TranVanVinh74/CAN_RTOS/node1-sensor/app/src/task_can_tx.c

#include "task_can_tx.h"

#include "FreeRTOS.h"
#include "task.h"

#include "app_cfg.h"
#include "app_ipc.h"
#include "can_protocol.h"
#include "hal_can.h"

volatile uint32_t g_canTxQueueTimeoutCount = 0;

static TaskHandle_t xCanTxTaskHandle = NULL;

static void prvCanTxTask(void *pvParameters) {
    (void)pvParameters;

    for (;;) {
        SensorData_t data;
        uint8_t payload[CAN_DLC_SENSOR];

        if (xQueueReceive(xSensorQueue, &data, pdMS_TO_TICKS(TASK_CAN_TX_QUEUE_WAIT_MS)) !=
            pdPASS) {
            g_canTxQueueTimeoutCount++;
            continue;
        }

        can_pack_sensor(data.temperature, data.humidity, data.gas_raw, data.sensor_faults, payload);
        hal_can_send(CAN_ID_SENSOR, payload, CAN_DLC_SENSOR);
    }
}

BaseType_t task_can_tx_create(void) {
    return xTaskCreate(prvCanTxTask, "CAN_TX", TASK_CAN_TX_STACK_WORDS, NULL, TASK_CAN_TX_PRIO,
                       &xCanTxTaskHandle);
}
