TranVanVinh74/CAN_RTOS/node3-gateway/app/inc/app_cfg.h

#ifndef APP_CFG_H
#define APP_CFG_H

#include "FreeRTOS.h"

#define TASK_COMM_PRIO (tskIDLE_PRIORITY + 2)
#define TASK_COMM_STACK_WORDS 512U
#define TASK_COMM_IDLE_DELAY_MS 1U
#define TASK_COMM_WAIT_DELAY_MS 10U

#define SENSOR_QUEUE_LENGTH 1U
#define THRESHOLD_QUEUE_LENGTH 1U
#define SENSOR_FRESH_TIMEOUT_MS 3000U

#define MODEM_BOOT_WAIT_MS 3000U
#define MODEM_AT_RETRY_MS 2000U
#define MODEM_IDLE_CHECK_MS 30000U

#define CALL_DURATION_MS 30000U
#define CALL_INTERVAL_MS 60000U

#endif
