TranVanVinh74/CAN_RTOS/node1-sensor/app/inc/app_cfg.h

#ifndef APP_CFG_H
#define APP_CFG_H

#include "FreeRTOS.h"

#define TASK_SENSOR_PRIO (tskIDLE_PRIORITY + 2)
#define TASK_SENSOR_STACK_WORDS 256U
#define TASK_SENSOR_PERIOD_MS 500U
#define TASK_SENSOR_MQ5_SAMPLES 8U
#define TASK_SENSOR_QUEUE_SEND_TIMEOUT_MS 10U

#define TASK_CAN_TX_PRIO (tskIDLE_PRIORITY + 3)
#define TASK_CAN_TX_STACK_WORDS 256U
#define TASK_CAN_TX_QUEUE_WAIT_MS 1000U

#define SENSOR_QUEUE_LENGTH 5U

#endif
