TranVanVinh74/CAN_RTOS/(commit log)

2026-10-31 chore(setup): add three-node STM32 FreeRTOS project skeleton
2026-10-31 feat(sensor): add DHT11 and MQ5 drivers for Node1
2026-11-02 feat(sensor): restore validated Node1 runtime from supplied project
2026-11-04 Verify Node2 TFT display with CAN sensor data
2026-11-04 Verify three-node CAN system with relay and call alerts at ADC 2000
2026-11-10 build: make keil projects regenerable and ignore build output
    - *.uvoptx was ignored, so a clean clone had no Node*.uvoptx; CubeMX
    6.14.1 then fails while updating the MDK-ARM project and leaves
    Node*.uvprojx with 7 of its 37 source files
    - track the default Node*.uvoptx generated by CubeMX (ST-Link selected);
    with it, regenerating keeps all files and the user-added Lib group
    - stop tracking .lnp, .sct and ExtDll.iex: Keil rewrites them on every
    build (memory layout comes from the target dialog)
    - ignore Keil and GCC build output, Python caches, editor and OS files,
    local secrets and local-only folders
2026-11-10 build: rename node projects by role
    - Node1/Node2/Node3 said nothing about what each board does, and the
    gateway project sat in a nested Node3/Node3 folder
    - rename the folders to node1-sensor, node2-actuator and node3-gateway
    and flatten the gateway folder
    - rename the .ioc, .uvprojx and .uvoptx files, the Keil target and
    output name, RTE/_<target> and the DebugConfig file to match, so
    CubeMX keeps updating the existing Keil project instead of creating a
    new one without the user-added Lib group and include path
    - update paths in the README and the build output pattern in .gitignore
    - checked: arm-none-eabi-gcc syntax check of every source listed in the
    three projects passes; Cub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
2026-11-10 build: move the three nodes from Keil MDK to STM32CubeIDE
    - the projects only built with Keil MDK and ARM Compiler 5, which run
    on Windows; development now happens on Ubuntu
    - replace MDK-ARM/ with STM32CubeIDE project files (.project, .cproject),
    the GCC startup file, the linker script and syscalls.c/sysmem.c, all
    generated by CubeMX 6.14.1 from STM32Cube FW_F1 V1.8.7
    - replace the FreeRTOS RVDS port with the GCC port of the same release
    - add Lib/ to the source folders and include paths of node1 and node2
    - Core/ is copied unchanged: main.c was edited outside the USER CODE
    blocks, so regenerating it from the .ioc would drop tested code
    (startup order, error codes, ADC sample time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
2026-11-10 build: keep .cproject in the format STM32CubeIDE writes
    - opening the projects in STM32CubeIDE 1.18.1 rewrote the three
    .cproject files: one include path and one source entry per line, and
    an empty build targets module in node3
    - commit the rewritten files so the IDE does not leave a diff behind;
    source folders and include paths are unchanged
2026-11-10 build: ignore STM32CubeIDE debug launch files
    - STM32CubeIDE creates <project>.launch on the first debug session; it
    holds per-machine settings such as the absolute ST-Link log path and
    the probe reset strategy
2026-11-10 docs: add MIT license
    - the repository had no license, so reuse terms were undefined
    - MIT covers the firmware written for this project; STM32 HAL, CMSIS
    and FreeRTOS keep their own licenses in their folders
2026-11-10 docs: rewrite the README as a short project entry point
    - the README had grown to 617 lines with personal notes, repository
    links, an outdated branch list and Keil-specific steps
    - keep the registered project title, the three ECU roles, features,
    repository structure, getting started and current limitations
2026-11-12 refactor(node1): split sensor firmware into bsp, hal and app layers
    main.c held the drivers, both tasks and the CAN framing, and its USER CODE
    markers were broken. Drivers move to hal/ (hal_mq5, hal_dht11, hal_can), pin
    mapping to bsp/, tasks and queue to app/, and the 0x100 frame layout to
    common/can_protocol.h. main.c now only initialises the board, IPC and tasks.
    Checked on the Node1 board: 0 warnings, 500 ms period, payload matches
    g_sensorDebug, CAN ESR shows ACK error with TEC +8 per frame as before.
2026-11-12 fix(node1): stop enabling CAN reception on the sensor node
    Node1 accepted every ID into FIFO0 and enabled the RX pending interrupt,
    but nothing read the FIFO. The first frame from another node kept the
    interrupt firing, starved both tasks and stopped the 0x100 frames.
    Node1 only transmits, so it no longer configures a filter or enables the
    RX interrupt; frames are still acknowledged on the bus.
    Checked on hardware: a 0x7E2 frame sent from Node2 froze the old Node1
    (Node2 stuck at 1003 frames); with this change Node1 keeps sending and
    Node2 keeps receiving 0x100 after the same frame.
2026-11-12 refactor(node2): split actuator firmware into bsp, hal and app layers
    main.c held the TFT and relay logic, the CAN filter and RX callback, and
    most CubeMX markers were gone. TFT, font, relay and CAN move to hal/
    (hal_tft, hal_tft_font, hal_relay, hal_can), pin mapping and error codes to
    bsp/, the task and queue to app/, and frame decoding to
    common/can_protocol.h. The CAN ISR now only reads the FIFO and hands frames
    to the app, and the TFT pins are defined once in main.h.
    Checked on the Node2 board with Node1 on the bus: 0 warnings, frames
    received and decoded to the values Node1 sent, TFT shows the data, the relay
    switches a 5 V fan when PB0 is driven high, with no reset or CAN errors.
2026-11-12 feat(node2): add hysteresis to the fan threshold
    The relay followed gas > 2000 directly, so a reading hovering around the
    threshold switched the fan on and off every frame (MQ-5 noise is about
    +-100). The fan now turns on above 2000 and off only below 1800, and
    keeps its state in between.
    Checked with a host test of the boundary values and on the Node2 board by
    overriding gas after reception: 2100 on, 1900 stays on, 1700 off, 1900
    stays off, two relay switches in total.
2026-11-12 refactor(node3): split gateway firmware into bsp, hal and app layers
    main.c held the modem I/O, the call state machine, the CAN filter and RX
    callback, and the alert phone number. CAN and the A7680C link move to
    hal/ (hal_can, hal_a7680c), error codes to bsp/, the call handling to
    app/app_call, the sensor freshness and alarm loop to app/task_comm, and
    frame decoding to common/can_protocol.h. The phone number now comes from
    an untracked app_secrets.h, with app_secrets.example.h as the fallback.
    Modem reception is still polled byte by byte as before.
    Checked on the Node3 board with Node1 on the bus: 0 warnings, 0x100
    frames received and fresh, the modem answers AT with OK.
2026-11-12 fix(node3): receive modem replies through an interrupt ring buffer
    The modem link was polled one byte at a time between task delays, so the
    USART overran and replies such as NO CARRIER, BUSY or ERROR were lost; a
    call always ran until the 30 s timeout. The RXNE interrupt now stores
    bytes in a 256-byte ring buffer that the task drains every loop, and the
    AT check waits with vTaskDelay instead of busy polling.
    Checked on the Node3 board: AT answered on the first attempt, 9 bytes
    received with no overrun or drop, CAN reception unaffected.
2026-11-12 fix(node3): end the call when the modem restarts mid-call
    During a test call the modem rebooted on a power dip right after the
    call connected. It sent its boot messages instead of NO CARRIER, so
    Node3 kept counting to the 30 s timeout and treated the alert as made.
    Modem replies are now classified in app_modem_reply: boot markers
    (+CPIN: READY, *ATREADY, RDY) end the call with stage 8, count the reset
    and force a new AT check; VOICE CALL: END is accepted as a normal end.
    Checked with a host test of real modem transcripts and on the Node3
    board by injecting +CPIN: READY during a call: stage 8, reset counted,
    AT re-checked. A real call to a hotline connected and was hung up at
    30 s without a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
2026-11-12 build(rtos): raise the heap to 6 KB and enable stack overflow checking
    All three nodes ran with 3 KB of heap and no way to measure stack use,
    leaving 700-800 bytes free and no room for the diagnostic task to come.
    configTOTAL_HEAP_SIZE is now 6144 (RAM use stays near 10 of 20 KB),
    configCHECK_FOR_STACK_OVERFLOW is 2 and uxTaskGetStackHighWaterMark is
    included; the .ioc files carry the same values and a scratch CubeMX
    generation reproduces FreeRTOSConfig.h. A stack overflow now records the
    task name in g_stackOverflowTask and stops through Error_Handler.
    Checked on the Node1 board: 3776 of 6144 bytes of heap free, SENSOR and
    CAN_TX use 44 of 256 words, no overflow reported.
2026-11-12 docs: describe the layered firmware and alert setup in the README
    The README still described the code before the layer split: the phone
    number in main.c, one fan threshold and a Node 3 that missed modem
    replies. It now shows the common/bsp/hal/app layout, the untracked
    app_secrets.h for the alert number, the bus wiring and the modem power
    and SIM requirements, and the limitations that remain.
2026-11-12 fix(node3): add hysteresis to the gas alarm
    The alarm used 2000 as both the on and off threshold, so a gas reading
    hovering around 2000 toggled the alarm on every frame and could start a
    new call each time the 60 s cooldown ran out. The alarm now clears only
    below 1800, the same band Node 2 uses for the fan. The README row for
    Node 3 states the band.
    Built with 0 warnings and flashed to Node 3; update_alarm compares
    against 2000 and 1800 and the board reaches the ready stage.
2026-11-12 build: keep CubeMX output files in LF
    STM32CubeMX writes every generated file with CRLF while the repository
    stores LF, so each generation marked dozens of unchanged files as
    modified. Core/, the .ioc files and .mxproject are now stored as LF.
    Drivers/ and Middlewares/ are not covered, so vendor files stay
    byte-identical.
2026-11-12 build(cubemx): sync node1 .ioc with the tested code and regenerate
    The .ioc still had ADC sample time 1.5 cycles and PA2 as an open-drain
    output, while the tested main.c used 239.5 cycles and an input with
    pull-up; regenerating would have silently undone both. The .ioc now
    matches the code and the project is regenerated. CubeMX always creates
    defaultTask, so the task deletes itself on its first run. Script
    generation requires configUSE_NEWLIB_REENTRANT, now enabled (76 bytes
    per task).
    A second generation produces no diff. Built with 0 warnings and run on
    the board: readings and CAN TX normal, 3 tasks, 3632 bytes heap free.
2026-11-12 build(cubemx): sync node2 .ioc with the tested code and regenerate
    The .ioc set the relay pin HIGH at reset, which turns the fan on at
    boot, and SPI prescaler 4 instead of the tested 32. The start-up error
    codes and the init order lived outside the USER CODE blocks. The .ioc
    now matches the code; each MX_*_Init records its step through
    bsp_board_set_init_step and Error_Handler stores it in g_errorCode, so
    the codes survive regeneration. defaultTask deletes itself and the
    hand-written tick callback that duplicated the generated one is gone.
    the board: fan off at boot, TFT draws readings, CAN received, 2 tasks,
    3800 bytes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
2026-11-12 build(cubemx): sync node3 .ioc with the tested code and regenerate
    The .ioc drove the modem PWRKEY pin as a HIGH output while the tested
    code leaves it as an input, and the start-up error codes lived outside
    the USER CODE blocks. The .ioc now matches the code, the error codes
    are recorded through bsp_board_set_init_step and Error_Handler,
    defaultTask deletes itself and the duplicated tick callback is gone.
    the board: modem ready (stage 3), 2 tasks, 3816 bytes heap free.
    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
2026-11-12 build(cubemx): run node2 SPI at 9 MHz and enable CAN automatic bus-off recovery
    The TFT ran at 2.25 MHz (prescaler 32), so a full redraw took about
    150 ms and animations were not possible. Prescaler 8 gives 9 MHz,
    within the ST7735 write clock limit. Automatic bus-off management was
    off, so after a bus-off Node 2 stayed silent until reset; it now
    rejoins the bus by itself.
    Both settings are in the .ioc and main.c; regenerating with CubeMX
    gives identical code. Flashed on Node 2: no SPI errors.
2026-11-12 feat(node2): show the readings as an animated car-style instrument cluster
    The display was plain text: readings, fan state and a status line,
    with no thresholds, no offline state and a full redraw on each frame.
    It now shows a gas gauge with a redline at the threshold and the gas
    level as a percentage of it, warning lamps for gas, temperature, fan
    and data, temperature and humidity readouts, and a settings screen
    ready for the four buttons. A start-up sweep, eased gauge movement,
    a blinking danger lamp and a rotating fan icon run at 40 ms frames,
    redrawing only changed tiles. The shown gas value is smoothed while
    the state and the fan still use the raw reading. Offline appears
    after 3 s with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
2026-11-12 refactor: name sensor encoding constants and fix the example guard
    The CAN payload packing and the DHT11 decoder used bare 8 and 0xFF for
    byte widths, and app_secrets.example.h used the generic guard
    _EXAMPLE_H. The byte width and mask are now named constants, the DHT11
    frame length is derived from its byte count, and the example header
    uses APP_SECRETS_EXAMPLE_H.
2026-11-12 docs: clarify display behavior and pending settings support
    The README said only that thresholds are fixed at build time. It now
    says the settings screen exists but cannot be opened until the four
    buttons are implemented, and lists temperature-based fan control,
    threshold sync to Node 3 and stored settings as pending. THIRD_PARTY.md
    names the display elements that use the fonts and icons.
2026-11-12 fix(node1): keep interrupts enabled during DHT11 reads
    The DHT11 frame read ran in a critical section, masking SysTick for
    4-5 ms per read so the tick fell behind real time. The read now
    suspends the scheduler instead, leaving interrupts enabled.
2026-11-13 build(cubemx): add threshold buttons to node2 pinout
    - configure PB12-PB15 as named GPIO inputs with internal pull-ups
    - keep CubeMX-generated pin definitions and initialization separate
    from application changes
    - generated with CubeMX 6.14.1; vendor sources remain unchanged
    - verified the isolated Node2 Debug build with zero warnings
2026-11-13 feat(node2): handle threshold buttons with debounced input
    - add a dedicated button driver with active-low polling and 40 ms debounce
    - scan from ACTUATOR every nominal 20 ms without adding a task
    - expose gas 500-3800 step 50 and temperature 30-50 C step 1 in SETTINGS
    - keep edits in RAM at this milestone; SAVE returns to the main screen
    - verified button host checks and the isolated Node2 Debug build
2026-11-13 feat(can): synchronize saved thresholds and apply hysteresis
    - share threshold defaults, validation and gas/temperature hysteresis
    - separate Node2 drafts from active settings and publish CAN 0x200
    at boot, after changed SAVE and every nominal second
    - use an independent latest-value threshold queue on Node3
    - apply saved limits to relay and automatic-call decisions without
    refreshing sensor timestamps from configuration frames
    - request automatic hang-up when the alarm clears or samples become stale
    - verified isolated Node2/Node3 Debug builds and host control-flow checks
    - final hardware integration verified SAVE synchronization and reset;
    no new-policy live call test was performed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
2026-11-13 feat(can): propagate sensor faults to both consumers
    - extend CAN 0x100 to five bytes with GAS and DHT fault bits
    - recompute flags each sampling cycle and reject reserved bits at RX
    - mask invalid readings in the UI and hold the fan until safety is known
    - during faults, trigger calls only from valid readings above limits
    - verified isolated Debug builds for all nodes and fault-policy host checks
    - final hardware integration verified DHT disconnection/reconnection,
    TFT error masking and Node3 flags 2 to 0 without call attempts
    - ADC and both-fault cases use host mocks; no live call was made
2026-11-13 docs: refresh Vietnamese README and UI previews
    - describe repository structure, wiring and threshold settings
    - show two UI previews and one startup animation near the end
    - distinguish source-rendered previews from hardware results
