TranVanVinh74/CAN_RTOS/(notices)

Notices in the files:
node2-actuator/Core/Inc/main.h:
Copyright (c) 2026 STMicroelectronics.
All rights reserved.
This software is licensed under terms that can be found in the LICENSE file
